KunstGraveren/uselessbox/README.md

**!! UPDATE !!**

Voor die de Useless Box hebben gemaakt tijdens The Reality 2025.

  - Bekende problemen:
      
      - Herstartende Nano
          - Servo vraagt net iets te veel stroom van de nano, waardoor een restart plaatsvindt.
          -   16v 470uF over de 5v / GND heen lost dit op. --> Arduino Nano Micro USB
          -   10v 1000uF over de 5v / GND heen lost dit op. --> Arduino Nano USB C
          
      - Niet bereiken van de schakelaar

  - Code Fixes:

      - v1.1: 
        - Eind posities zijn niet meer hardcoded, schakelaar interrupt is gebruikt om te "detecteren" wanneer de servo moet stoppen.
        - Wanneer de Box wordt aangesloten op stroom (usb), en de schakelaar staat omhoog. Dan zal die de schakelaar omhalen, en daar stoppen. Reset de nano door opnieuw de usb kabel aan te sluiten. In de Serial Console, is nu ook de positie terug te lezen waar de schakelaar zich bevindt. (debug)
       
      - v1.7
        -  refctor code & added a dogwach for reset on powerfailer (usb-c arduino nano unit experance a freeze. the dogwach reset the arduino nano if this happends)
---
# Binaire Firmware Web uploade
U can flash your arduino nano using the web uploadd: https://kunstgraveren.github.io/

# uselessbox  
Een 'overbodige' doos is een fascinerend en vaak humoristisch project dat perfect is voor beginners. Het is een eenvoudig apparaat dat in feite één functie heeft: het inschakelen van een schakelaar en vervolgens zichzelf weer uitschakelen.

Hier is een samenvatting en uitleg van de code, samen met de verschillen tussen elke actie, en een eenvoudig schakelschema:

### Code Samenvatting:
- Het systeem gebruikt een Arduino Nano met:
  - Een servo motor (`handServo`) die een "hand" beweging bestuurt.
  - Een WS2812 LED (`FastLED`) die de status aangeeft.
  - Een schakelaar verbonden met pin 3, waarmee door acties gewisseld wordt.
- Wanneer de schakelaar wordt ingedrukt, triggert een interrupt (`handleSwitchInterrupt`) dat de variabele `action` verhoogt, en deze loopt van 1 tot 7.
- De `loop()` controleert de waarde van `action` en voert verschillende vooraf ingestelde sequences uit, met servo-bewegingen, vertragingen en seriële berichten.
- Elke actie simuleert een andere "truc" zoals het openen van een doos, het bewegen van de hand, waggelen, etc.
- Tijdens een actie wordt de LED rood; na afloop gaat hij terug naar blauw.

---

### Schakelschema:
**Benodigdheden:**
- Arduino Nano
- Schakelaar MTS102 ON-ON
- Servo motor SG90
- WS2812B LED-strip (1 LED)
- **Condensator (16v 470uF / 10v 1000uF)

** Sommige Nano icm de servo zorgt ervoor dat die in een "restart" loop komt, indien dit gebeurd plaats/gebruik de condensator volgends de tekening.

**Aansluitingen:**




```
[Arduino]
    D2    ---->     Data pin voor LED (WS2812B)
    D3    ---->     Schakelaar ----> GND (met interne pull-up ingeschakeld)
    D4    ---->     Signaalpin servo
    +5V   ---->     V+ servo / V+ LED ---|
                                          -> Condensator
    GND   ---->     GND servo -----------|
                    GND schakelaar ------| 
                    GND LED -------------|
```
