KunstGraveren/uselessbox/instructions-images/soldering-05-pre.jpeg

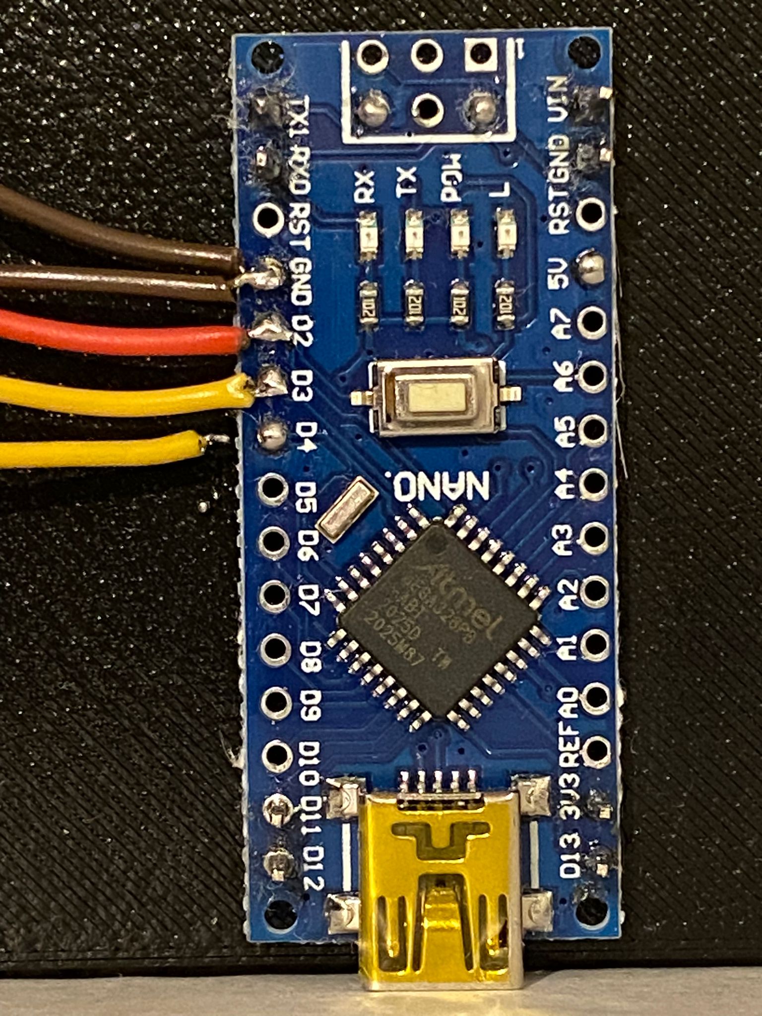
instructions-images/soldering-05-pre.jpeg
