KunstGraveren/uselessbox/instructions-images/soldering-06-pre.jpeg

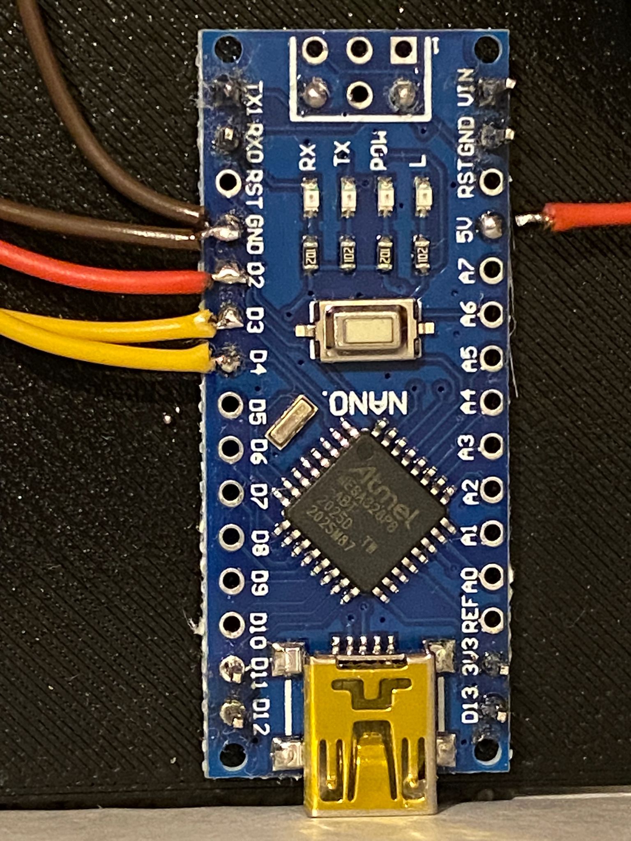
instructions-images/soldering-06-pre.jpeg
