KunstGraveren/uselessbox/instructions-images/uselessbox-tr.png

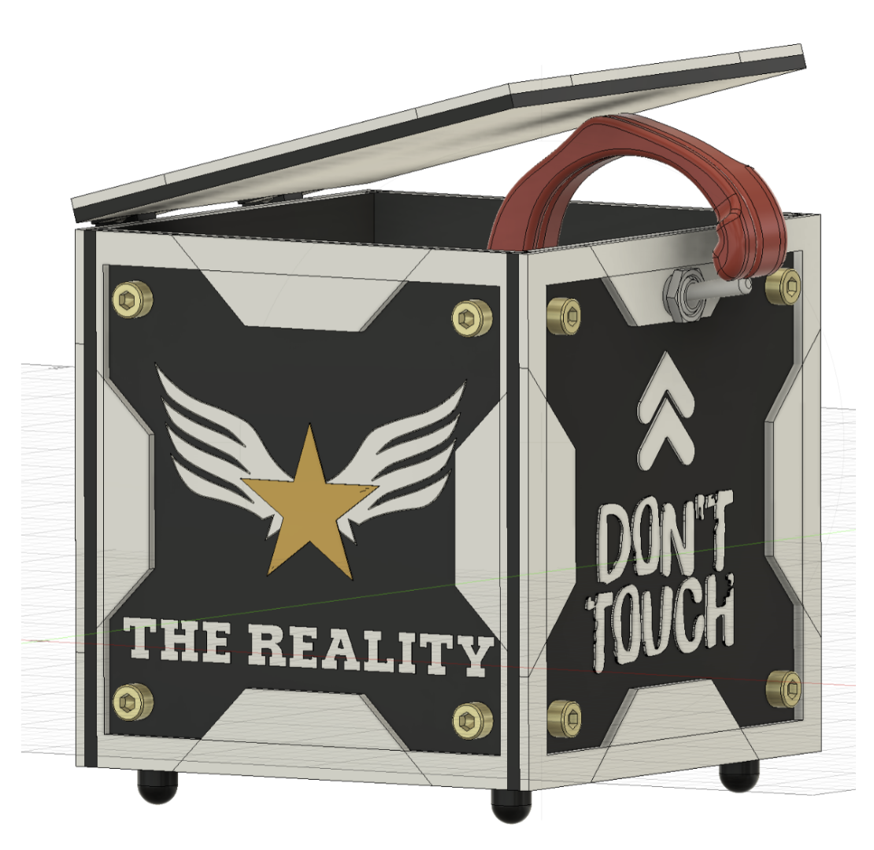
instructions-images/uselessbox-tr.png
