KunstGraveren/uselessbox/(commit log)

2025-09-22 Update uselessbox.ino to V1.1
    fix end positions for servo trough the switch interrupt pin
    [uselessbox.ino]
2026-09-22 Create Reduce Switch Force for new switches.md
2026-09-22 Rename Reduce Switch Force for new switches.md to instructies-reduce_switch_force.md
